chris-markus/new-old-phone/Knob Legend.pdf

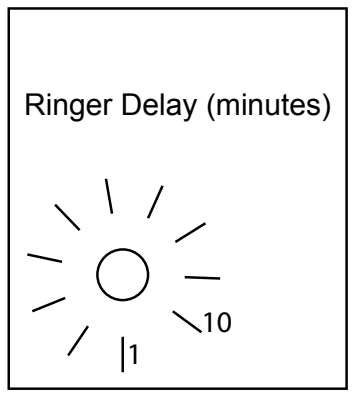
[picture p1: figure]
Ringer Delay (minutes)
